SRMskyward/SkyHeart/Skyfall_Avionic.kicad_pcb

## KiCad design Skyfall_Avionic.kicad_pcb (2025-07-17)

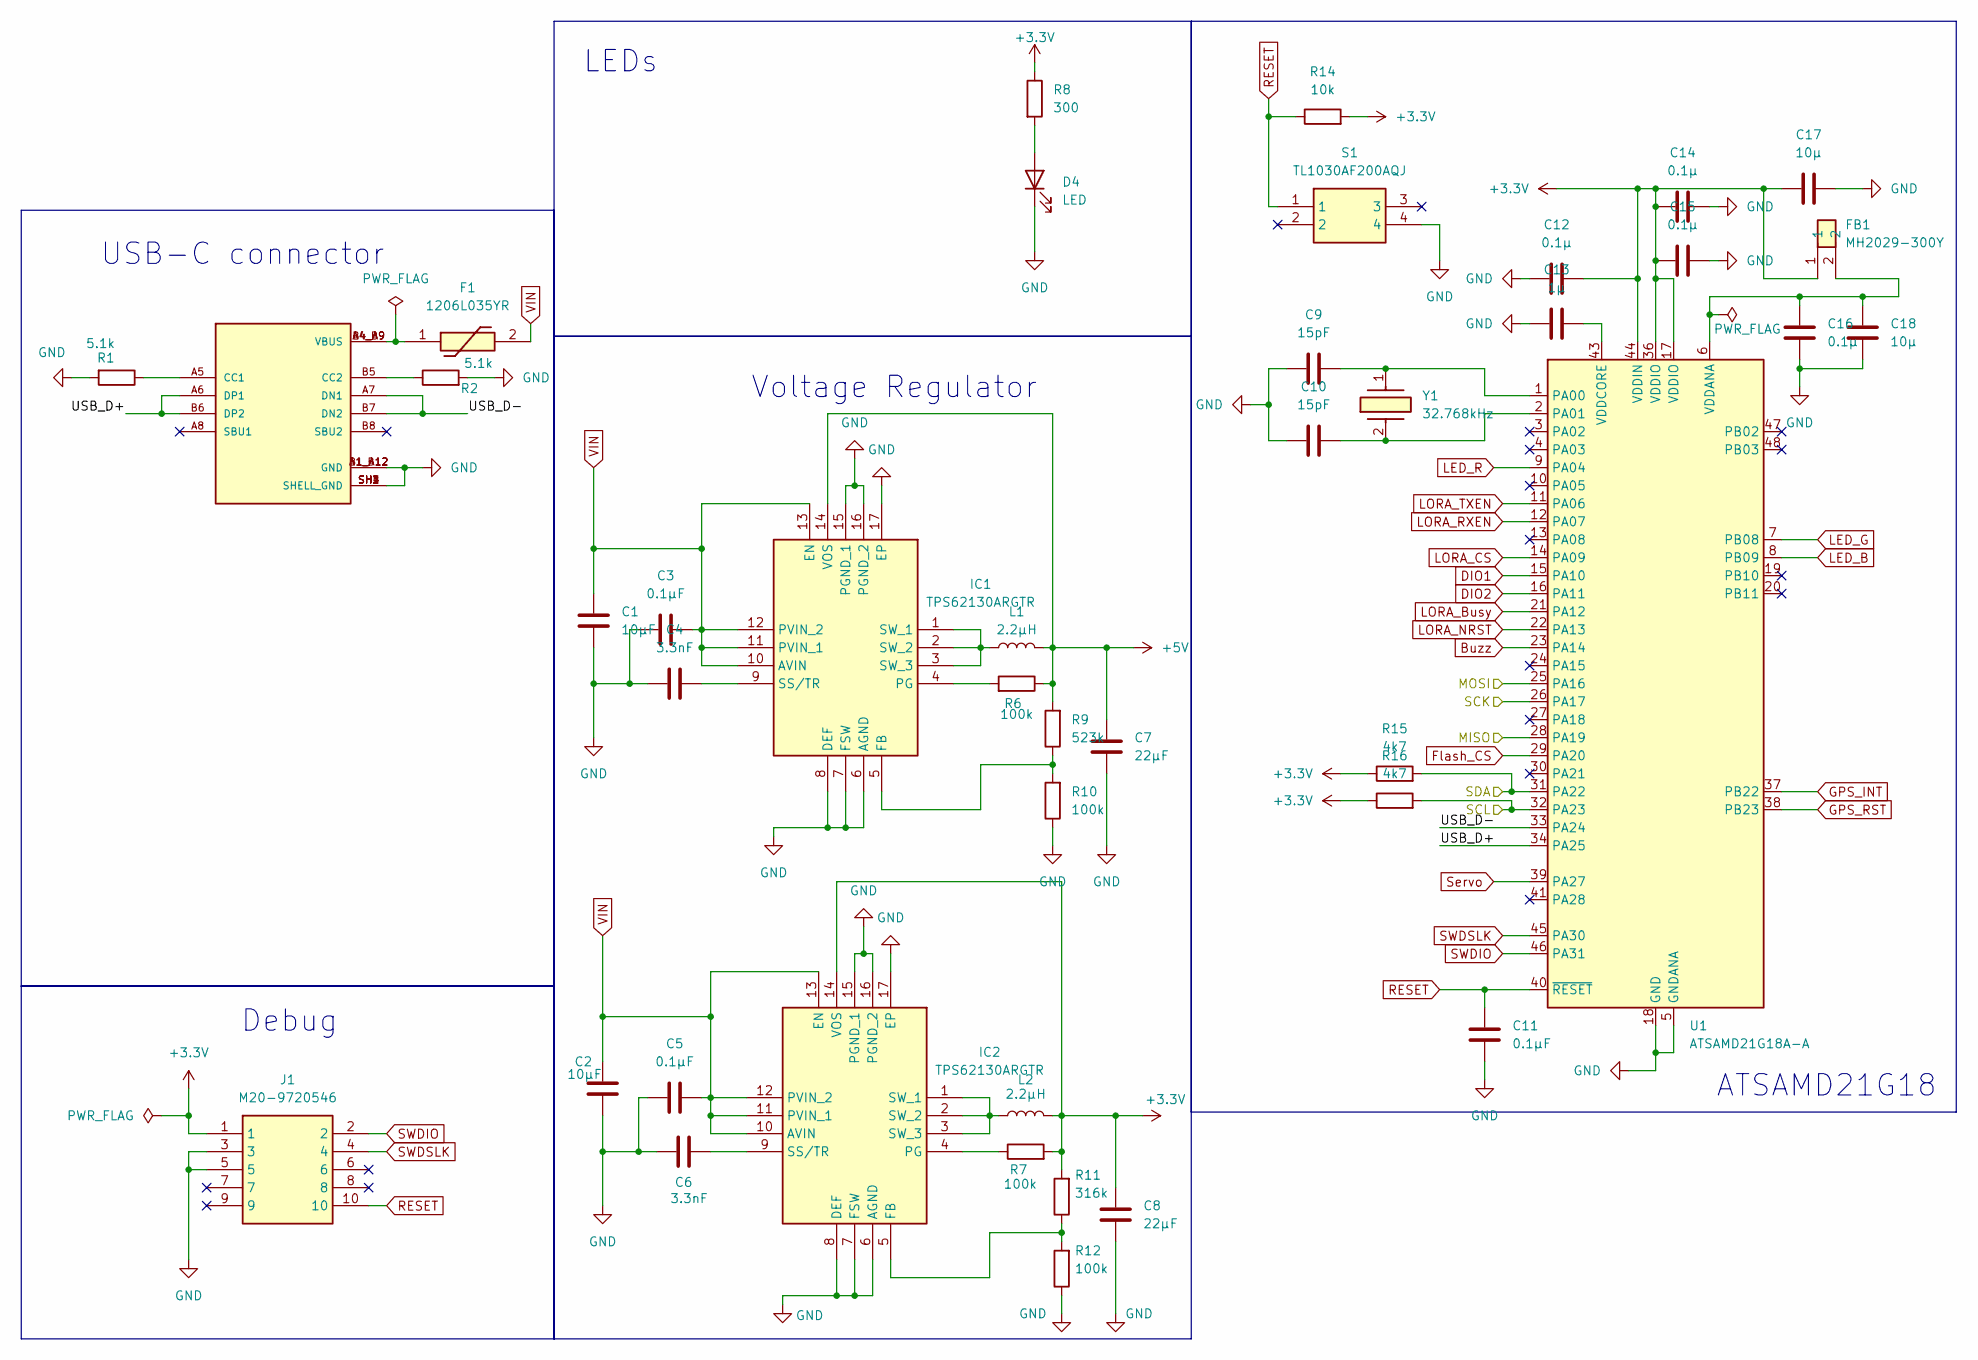
[picture p1: schematic MCU.kicad_sch]

Parts:
C1, C2: 10µF; C_0603_1608Metric
C3, C5, C11: 0.1µF; C_0603_1608Metric
C4, C6: 3.3nF; C_0603_1608Metric
C7, C8: 22µF; C_0603_1608Metric
C9, C10: 15pF; C_0603_1608Metric
C12, C14, C15, C16: 0.1µ; C_0603_1608Metric
C13: 1µ; C_0603_1608Metric
C17, C18: 10µ; C_0603_1608Metric
D4: LED; LED_0805_2012Metric
F1: 1206L035YR; 1206L05015YR; Mouser Part Number 576-1206L035YR
FB1: MH2029-300Y; BEADC2016X130N; Mouser Part Number 652-MH2029-300Y
IC1, IC2: TPS62130ARGTR; QFN50P300X300X100-17N-D; Mouser Part Number 595-TPS62130ARGTR
J1: M20-9720546; HDRV10W64P254_2X5_1270X508X954P; Mouser Part Number 855-M20-9720546
J2: USB4105-GF-A-060; GCT_USB4105-GF-A-060; PARTREV B3
L1, L2: 2.2µH; L_TDK_NLV32_3.2x2.5mm
R1, R2: 5.1k; R_0603_1608Metric
R6, R7, R10, R12: 100k; R_0603_1608Metric
R8: 300; R_0603_1608Metric
R9: 523k; R_0603_1608Metric
R11: 316k; R_0603_1608Metric
R14: 10k; R_0603_1608Metric
R15, R16: 4k7; R_0603_1608Metric
S1: TL1030AF200AQJ; Mouser Part Number 612-TL1030AF200AQJ
U1: ATSAMD21G18A-A; TQFP-48_7x7mm_P0.5mm
Y1: 32.768kHz; VMK3900132K7680000; Mouser Part Number 579-K3900132K7680000

Connections:
+3.3V: C8.2, C12.1, C14.2, C15.2, C17.2, FB1.1, IC2.14 (VOS), J1.1, L2.2, R7.2, R8.1, R11.2, R14.2, R15.1, R16.1, U1.17 (VDDIO), U1.36 (VDDIO), U1.44 (VDDIN); also elsewhere on the board
+5V: C7.2, IC1.14 (VOS), L1.2, R6.1, R9.2; also elsewhere on the board
/Actionners_&_connectors/MISO: U1.28 (PA19); also elsewhere on the board
/Actionners_&_connectors/MOSI: U1.25 (PA16); also elsewhere on the board
/Actionners_&_connectors/SCK: U1.26 (PA17); also elsewhere on the board
/Actionners_&_connectors/SCL: R16.2, U1.32 (PA23); also elsewhere on the board
/Actionners_&_connectors/SDA: R15.2, U1.31 (PA22); also elsewhere on the board
/MCU/USB_D+: J2.A6 (DP1), J2.B6 (DP2), U1.34 (PA25)
/MCU/USB_D-: J2.A7 (DN1), J2.B7 (DN2), U1.33 (PA24)
Buzz: U1.23 (PA14); also elsewhere on the board
DIO1: U1.15 (PA10); also elsewhere on the board
DIO2: U1.16 (PA11); also elsewhere on the board
Flash_CS: U1.29 (PA20); also elsewhere on the board
GND: C1.1, C2.1, C3.1, C4.1, C5.1, C6.1, C7.1, C8.1, C9.2, C10.2, C11.2, C12.2, C13.2, C14.1, C15.1, C16.2, C17.1, C18.2, D4.1 (K), IC1.6 (AGND), IC1.7 (FSW), IC1.8 (DEF), IC1.15 (PGND_1), IC1.16 (PGND_2), IC1.17 (EP), IC2.6 (AGND), IC2.7 (FSW), IC2.8 (DEF), IC2.15 (PGND_1), IC2.16 (PGND_2), IC2.17 (EP), J1.3, J1.5, J2.A1_B12 (GND), J2.B1_A12 (GND), J2.SH1 (SHELL_GND), J2.SH2 (SHELL_GND), J2.SH3 (SHELL_GND), J2.SH4 (SHELL_GND), R1.2, R2.2, R10.1, R12.1, S1.4, U1.5 (GNDANA), U1.18 (GND), U1.35 (GND), U1.42 (GND); also elsewhere on the board
GPS_INT: U1.37 (PB22)
GPS_RST: U1.38 (PB23)
LED_B: U1.8 (PB09); also elsewhere on the board
LED_G: U1.7 (PB08); also elsewhere on the board
LED_R: U1.9 (PA04); also elsewhere on the board
LORA_Busy: U1.21 (PA12); also elsewhere on the board
LORA_CS: U1.14 (PA09); also elsewhere on the board
LORA_NRST: U1.22 (PA13); also elsewhere on the board
LORA_RXEN: U1.12 (PA07); also elsewhere on the board
LORA_TXEN: U1.11 (PA06); also elsewhere on the board
unnamed: D4.2 (A), R8.2
unnamed: F1.1, J2.A4_B9 (VBUS), J2.B4_A9 (VBUS)
unnamed: IC1.5 (FB), R9.1, R10.2
unnamed: IC1.4 (PG), R6.2
unnamed: C4.2, IC1.9 (SS/TR)
unnamed: IC1.1 (SW_1), IC1.2 (SW_2), IC1.3 (SW_3), L1.1
unnamed: IC2.5 (FB), R11.1, R12.2
unnamed: IC2.4 (PG), R7.1
unnamed: C6.2, IC2.9 (SS/TR)
unnamed: IC2.1 (SW_1), IC2.2 (SW_2), IC2.3 (SW_3), L2.1
unnamed: J2.A5 (CC1), R1.1
unnamed: J2.B5 (CC2), R2.1
unnamed: C9.1, U1.1 (PA00), Y1.1 (CRYSTAL)
unnamed: C10.1, U1.2 (PA01), Y1.2 (CRYSTAL)
unnamed: C16.1, C18.1, FB1.2, U1.6 (VDDANA)
unnamed: C13.1, U1.43 (VDDCORE)
RESET: C11.1, J1.10, R14.1, S1.1, U1.40 (~RESET)
SWDIO: J1.2, U1.46 (PA31)
SWDSLK: J1.4, U1.45 (PA30)
Servo: U1.39 (PA27); also elsewhere on the board
VIN: C1.2, C2.2, C3.2, C5.2, F1.2, IC1.10 (AVIN), IC1.11 (PVIN_1), IC1.12 (PVIN_2), IC1.13 (EN), IC2.10 (AVIN), IC2.11 (PVIN_1), IC2.12 (PVIN_2), IC2.13 (EN); also elsewhere on the board

Notes on the sheet:
ATSAMD21G18
USB-C connector
LEDs
Voltage Regulator
Debug

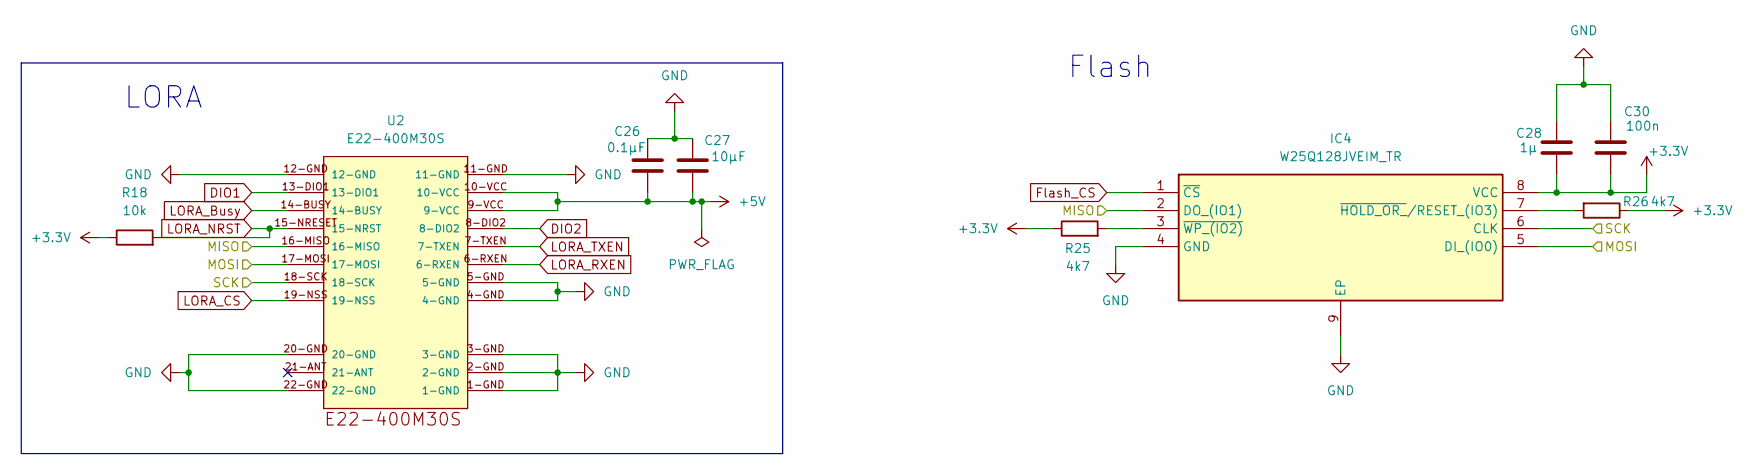
[picture p2: schematic LORA.kicad_sch]

Parts:
C26: 0.1µF; C_0603_1608Metric
C27: 10µF; C_0603_1608Metric
C28: 1µ; C_0603_1608Metric
C30: 100n; C_0603_1608Metric
IC4: W25Q128JVEIM_TR; SON127P800X600X80-9N-D; Mouser Part Number 454-W25Q128JVEIMTR
R18: 10k; R_0603_1608Metric
R25, R26: 4k7; R_0603_1608Metric
U2: E22-400M30S

Connections:
+3.3V: C28.1, C30.1, IC4.8 (VCC), R18.1, R25.1, R26.1; also elsewhere on the board
+5V: C26.1, C27.1, U2.9-VCC, U2.10-VCC; also elsewhere on the board
/Actionners_&_connectors/MISO: IC4.2 (DO_(IO1)), U2.16-MISO; also elsewhere on the board
/Actionners_&_connectors/MOSI: IC4.5 (DI_(IO0)), U2.17-MOSI; also elsewhere on the board
/Actionners_&_connectors/SCK: IC4.6 (CLK), U2.18-SCK; also elsewhere on the board
DIO1: U2.13-DIO1; also elsewhere on the board
DIO2: U2.8-DIO2; also elsewhere on the board
Flash_CS: IC4.1 (~CS); also elsewhere on the board
GND: C26.2, C27.2, C28.2, C30.2, IC4.4 (GND), IC4.9 (EP), U2.1-GND, U2.2-GND, U2.3-GND, U2.4-GND, U2.5-GND, U2.11-GND, U2.12-GND, U2.20-GND, U2.22-GND; also elsewhere on the board
LORA_Busy: U2.14-BUSY; also elsewhere on the board
LORA_CS: U2.19-NSS; also elsewhere on the board
LORA_NRST: R18.2, U2.15-NRESET (15-NRST); also elsewhere on the board
LORA_RXEN: U2.6-RXEN; also elsewhere on the board
LORA_TXEN: U2.7-TXEN; also elsewhere on the board
unnamed: IC4.7 (~HOLD_OR_/RESET_(IO3)), R26.2
unnamed: IC4.3 (~WP_(IO2)), R25.2

Notes on the sheet:
LORA
Flash

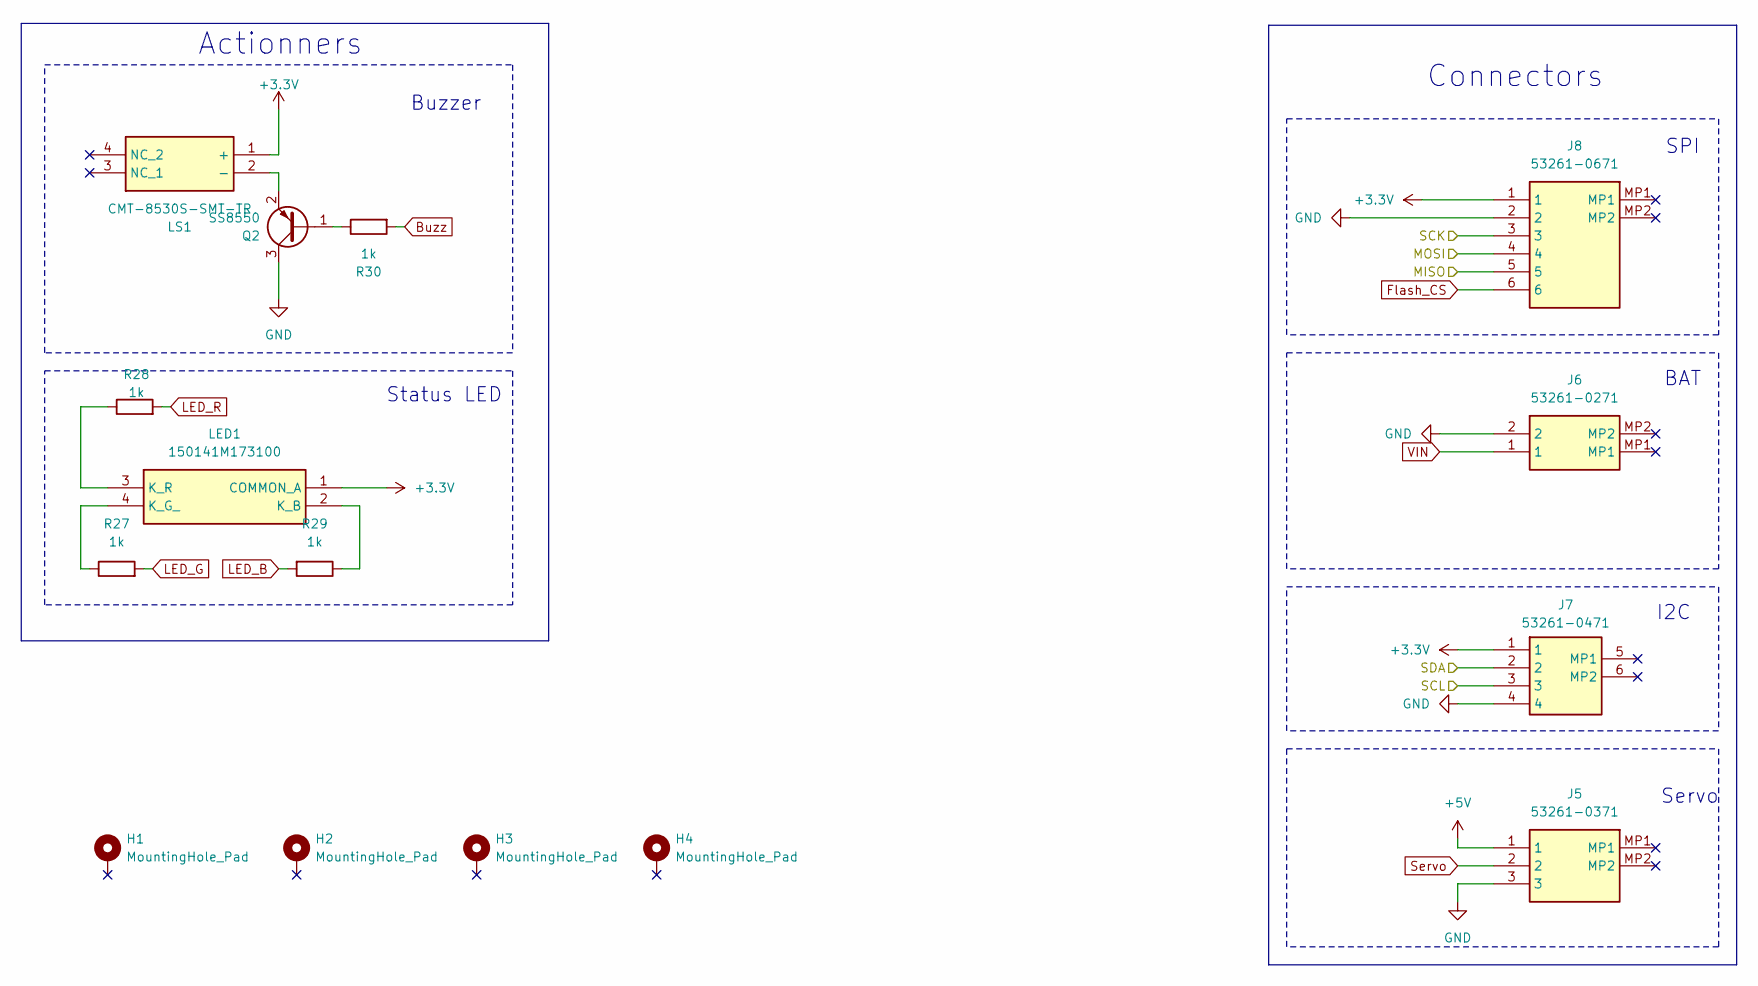
[picture p3: schematic actionners.kicad_sch]

Parts:
H1, H2, H3, H4: MountingHole_Pad; MountingHole_2.7mm_M2.5_Pad
J5: 53261-0371; 532610371; Mouser Part Number 538-53261-0371
J6: 53261-0271; 532610271; Mouser Part Number 538-53261-0271
J7: 53261-0471; Mouser Part Number 538-53261-0471
J8: 53261-0671; 532610671; Mouser Part Number 538-53261-0671
LED1: 150141M173100; Mouser Part Number 710-150141M173100
LS1: CMT-8530S-SMT-TR; CMT8530SSMTTR; Mouser Part Number 490-CMT-8530S-SMT-TR
Q2: SS8550; SOT-23
R27, R28, R29, R30: 1k; R_0603_1608Metric

Connections:
+3.3V: J7.1, J8.1, LED1.1 (COMMON_A), LS1.1 (+); also elsewhere on the board
+5V: J5.1; also elsewhere on the board
/Actionners_&_connectors/MISO: J8.5; also elsewhere on the board
/Actionners_&_connectors/MOSI: J8.4; also elsewhere on the board
/Actionners_&_connectors/SCK: J8.3; also elsewhere on the board
/Actionners_&_connectors/SCL: J7.3; also elsewhere on the board
/Actionners_&_connectors/SDA: J7.2; also elsewhere on the board
Buzz: R30.2; also elsewhere on the board
Flash_CS: J8.6; also elsewhere on the board
GND: H1.1, H2.1, H3.1, H4.1, J5.3, J6.2, J7.4, J8.2, Q2.3 (C); also elsewhere on the board
LED_B: R29.2; also elsewhere on the board
LED_G: R27.2; also elsewhere on the board
LED_R: R28.2; also elsewhere on the board
unnamed: LED1.2 (K_B), R29.1
unnamed: LED1.4 (K_G_), R27.1
unnamed: LED1.3 (K_R), R28.1
unnamed: LS1.2 (-), Q2.2 (E)
unnamed: Q2.1 (B), R30.1
Servo: J5.2; also elsewhere on the board
VIN: J6.1; also elsewhere on the board

Notes on the sheet:
Buzzer
Actionners
Status LED
BAT
SPI
Servo
I2C
Connectors

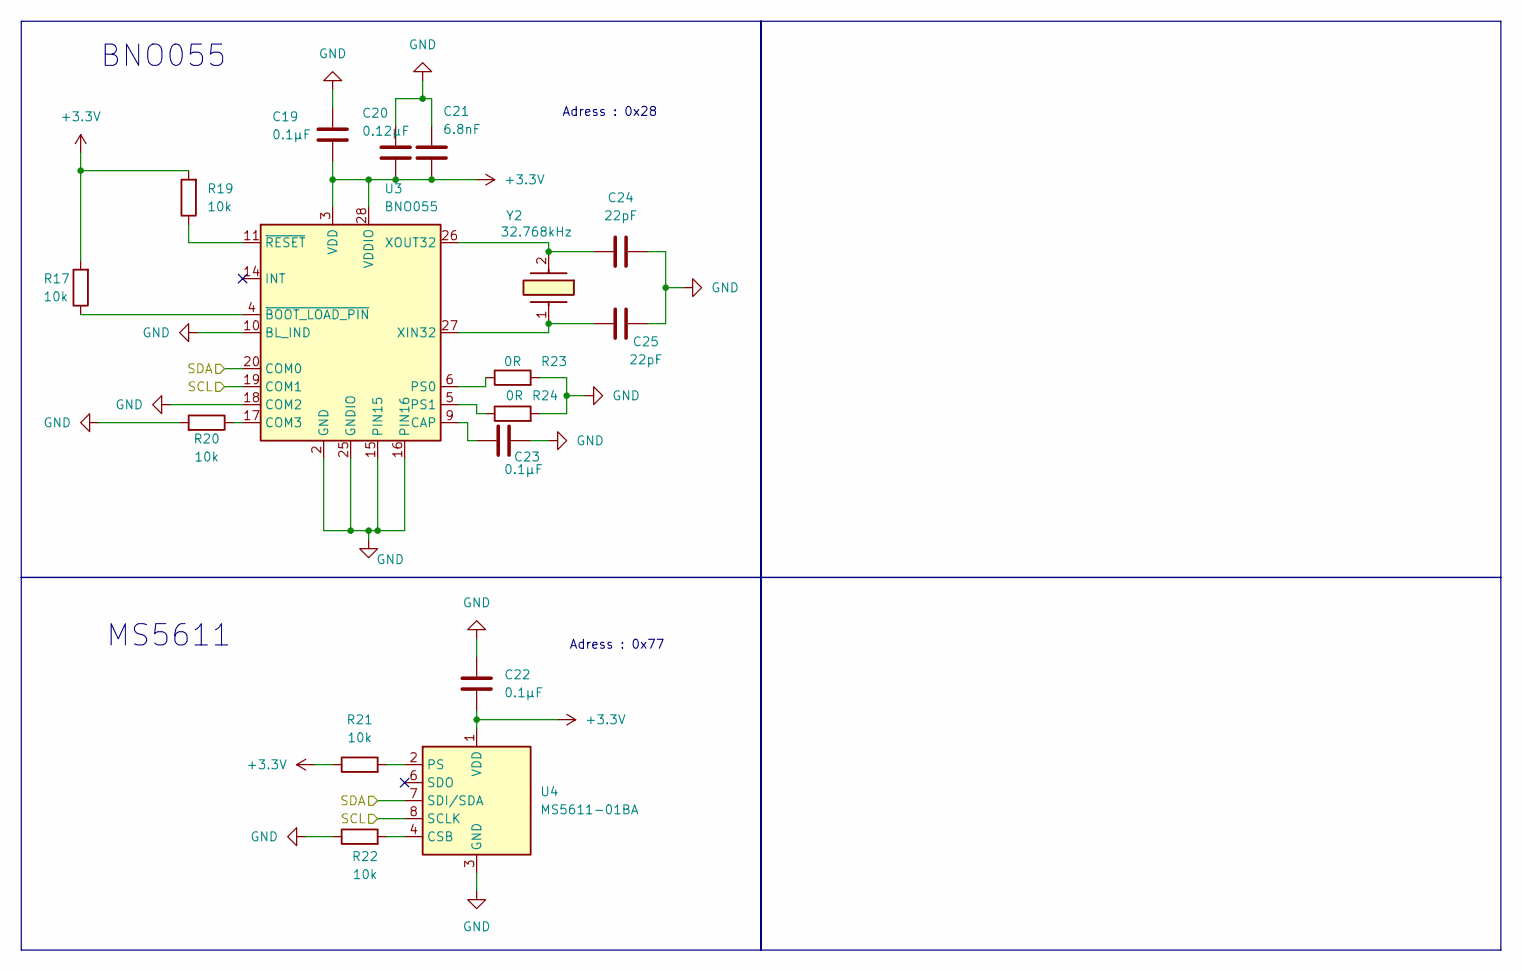
[picture p4: schematic samd21.kicad_sch]

Parts:
C19, C22, C23: 0.1µF; C_0603_1608Metric
C20: 0.12µF; C_0603_1608Metric
C21: 6.8nF; C_0603_1608Metric
C24, C25: 22pF; C_0603_1608Metric
R17, R19, R20, R21, R22: 10k; R_0603_1608Metric
R23, R24: 0R; R_0603_1608Metric
U3: BNO055; LGA-28_5.2x3.8mm_P0.5mm
U4: MS5611-01BA; LGA-8_3x5mm_P1.25mm
Y2: 32.768kHz; VMK3900132K7680000; Mouser Part Number 579-K3900132K7680000

Connections:
+3.3V: C19.1, C20.1, C21.1, C22.1, R17.2, R19.2, R21.1, U3.3 (VDD), U3.28 (VDDIO), U4.1 (VDD); also elsewhere on the board
/Actionners_&_connectors/SCL: U3.19 (COM1), U4.8 (SCLK); also elsewhere on the board
/Actionners_&_connectors/SDA: U3.20 (COM0), U4.7 (SDI/SDA); also elsewhere on the board
GND: C19.2, C20.2, C21.2, C22.2, C23.2, C24.2, C25.2, R20.2, R22.1, R23.2, R24.2, U3.2 (GND), U3.10 (BL_IND), U3.15 (PIN15), U3.16 (PIN16), U3.18 (COM2), U3.25 (GNDIO), U4.3 (GND); also elsewhere on the board
unnamed: R22.2, U4.4 (CSB), U4.5 (CSB)
unnamed: C23.1, U3.9 (CAP)
unnamed: R20.1, U3.17 (COM3)
unnamed: R23.1, U3.6 (PS0)
unnamed: R24.1, U3.5 (PS1)
unnamed: C25.1, U3.27 (XIN32), Y2.1 (CRYSTAL)
unnamed: C24.1, U3.26 (XOUT32), Y2.2 (CRYSTAL)
unnamed: R17.1, U3.4 (~BOOT_LOAD_PIN)
unnamed: R19.1, U3.11 (~RESET)
unnamed: R21.2, U4.2 (PS)

Notes on the sheet:
BNO055
Adress : 0x77
MS5611
Adress : 0x28

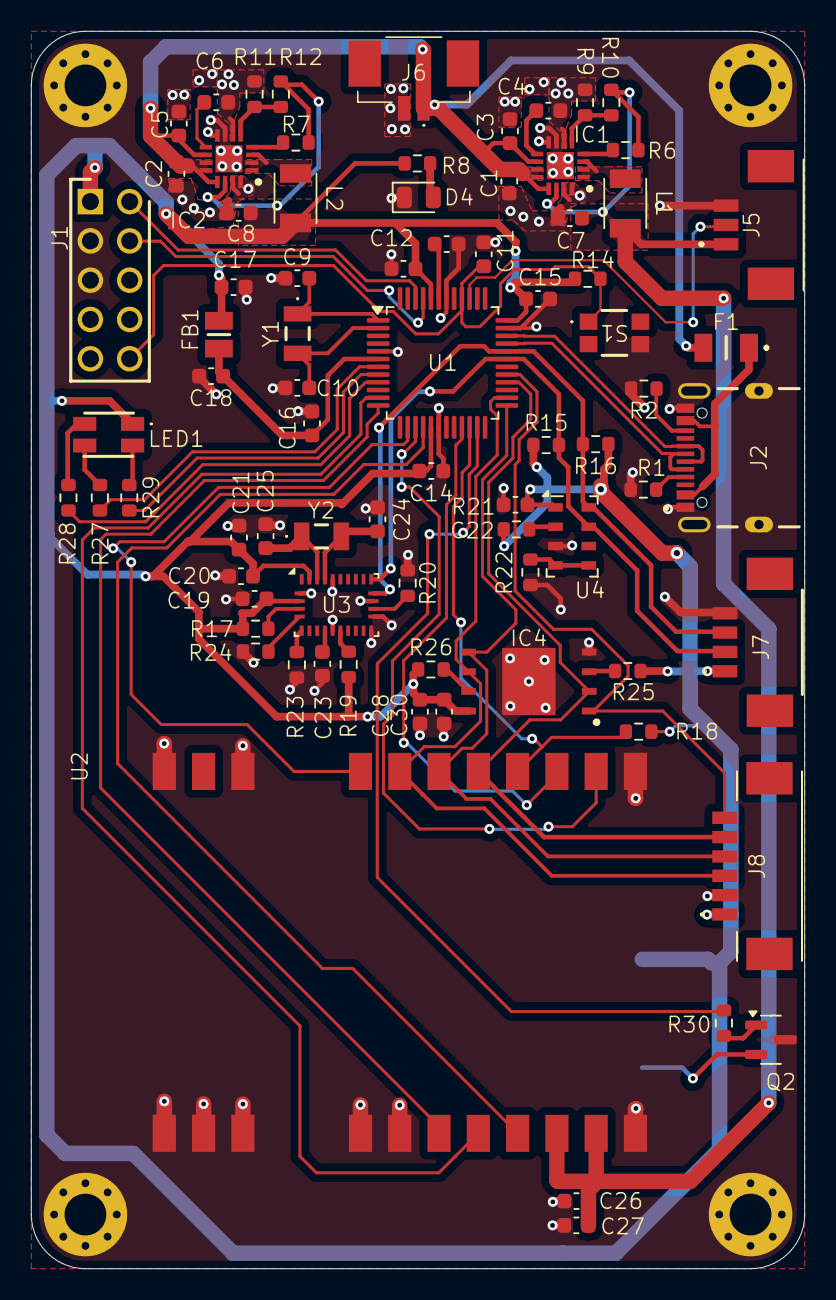
[picture p5: board Skyfall_Avionic.kicad_pcb from above]

Board: 2 copper layers, 50.0 x 80.0 mm, 83 parts (1 on the bottom side), 60 nets.
