SRMskyward/SkyHeart/(commit log)

2025-07-16 First draft
    [LORA.kicad_sch, MCU.kicad_sch, Skyfall_Avionic.kicad_pcb, Skyfall_Avionic.kicad_sch, actionners.kicad_sch, samd21.kicad_sch, untitled.kicad_sch]
2025-07-16 Minor PCB Changes
    [Skyfall_Avionic.kicad_pcb]
2025-07-16 PCB Review
    [Skyfall_Avionic.kicad_pcb]
